MAZI2/Emergent-Behaviour-Fireflies/schematics_n_stuff/PIFCamp_Kresnicka_25_v1.1.kicad_pcb

## KiCad design schematics_n_stuff/PIFCamp_Kresnicka_25_v1.1.kicad_pcb (2025-07-19)

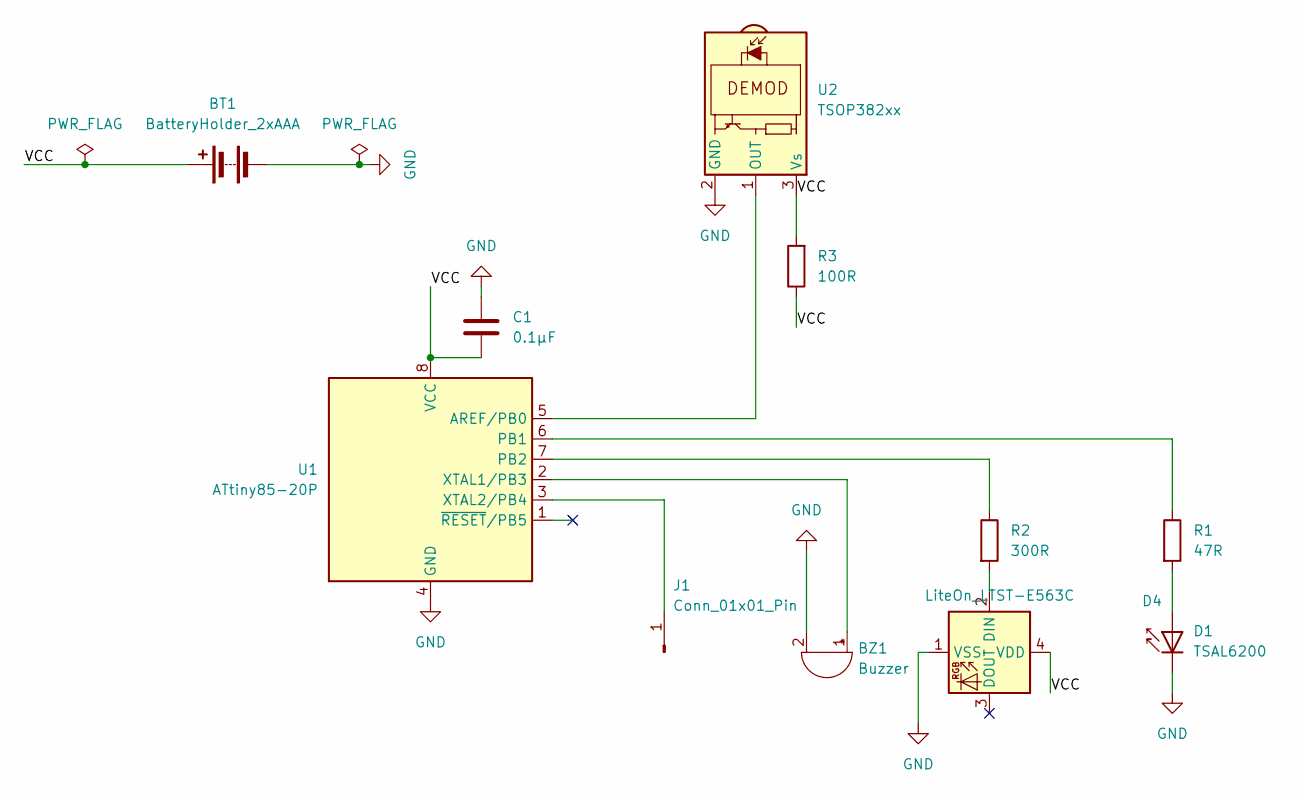
[picture p1: schematic PIFCamp_Kresnicka_25_v1.1.kicad_sch, Kresnica v1.1]

Parts:
BT1: BatteryHolder_2xAAA; TestPoint_2Pads_Pitch5.08mm_Drill1.3mm
BZ1: Buzzer; Buzzer_TDK_PS1240P02BT_D12.2mm_H6.5mm
C1: 0.1µF; C_1206_3216Metric_Pad1.33x1.80mm_HandSolder
D1: TSAL6200; LED_D3.0mm
D4: LiteOn_LTST-E563C; LED_D5.0mm-4_RGB_Wide_Pins
J1: Conn_01x01_Pin; TestPoint_Pad_1.0x1.0mm
R1: 47R; R_1206_3216Metric_Pad1.30x1.75mm_HandSolder
R2: 300R; R_1206_3216Metric_Pad1.30x1.75mm_HandSolder
R3: 100R; R_1206_3216Metric_Pad1.30x1.75mm_HandSolder
U1: ATtiny85-20P; DIP-8_W7.62mm_LongPads
U2: TSOP382xx; Vishay_MINICAST-3Pin

Connections:
/VCC: BT1.1 (+), C1.1, D4.4 (VDD), R3.1, R3.2, U1.8 (VCC), U2.3 (Vs)
GND: BT1.2 (-), BZ1.2 (-), C1.2, D1.1 (K), D4.1 (VSS), U1.4 (GND), U2.2 (GND)
unnamed: BZ1.1 (+), U1.2 (XTAL1/PB3)
unnamed: D1.2 (A), R1.2
unnamed: D4.2 (DIN), R2.2
unnamed: J1.1, U1.3 (XTAL2/PB4)
unnamed: U1.5 (AREF/PB0), U2.1 (OUT)
unnamed: R1.1, U1.6 (PB1)
unnamed: R2.1, U1.7 (PB2)

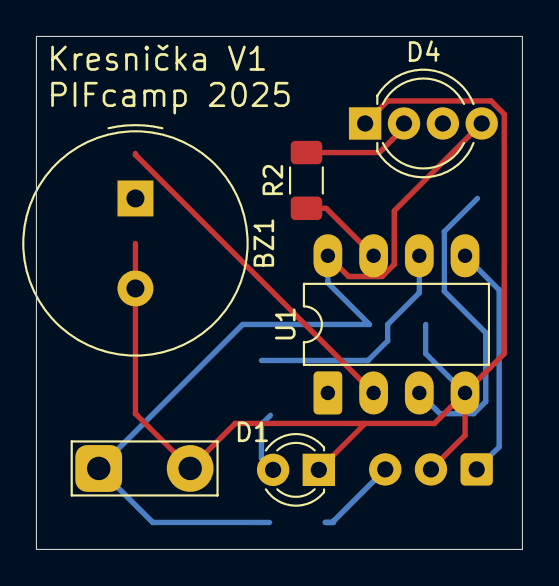
[picture p2: board PIFCamp_Kresnicka_25_v1.1.kicad_pcb from above]

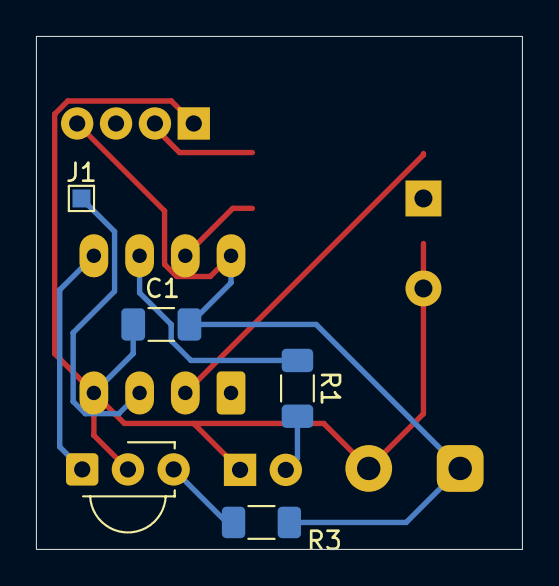
[picture p3: board PIFCamp_Kresnicka_25_v1.1.kicad_pcb from below]

Board: 2 copper layers, 27.0 x 28.5 mm, 11 parts (5 on the bottom side), 9 nets.
