MAZI2/Emergent-Behaviour-Fireflies/(commit log)

2025-07-07 pcb and schematics
    [PIFCamp_Kresnicka_25_v1.1.kicad_pcb, PIFCamp_Kresnicka_25_v1.1.kicad_sch]
2025-07-08 updated pcb
    [PIFCamp_Kresnicka_25_v1.1.kicad_pcb, PIFCamp_Kresnicka_25_v1.1.kicad_sch]
2025-07-08 wider tracks
    [bom.csv, designators.csv, positions.csv]
2026-05-28 Add fallback timer for sleep transition
